Shuvadeep2407/cir/2.png

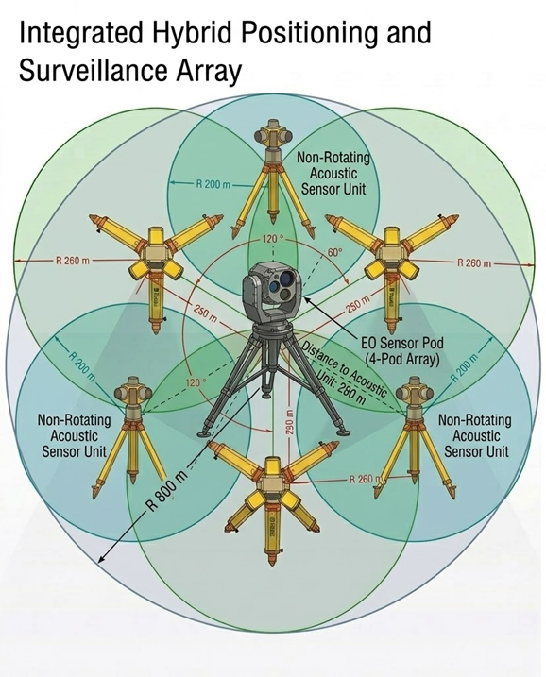
2.png
