Shuvadeep2407/cir/300 mm acoustic parabolic dish.jpg

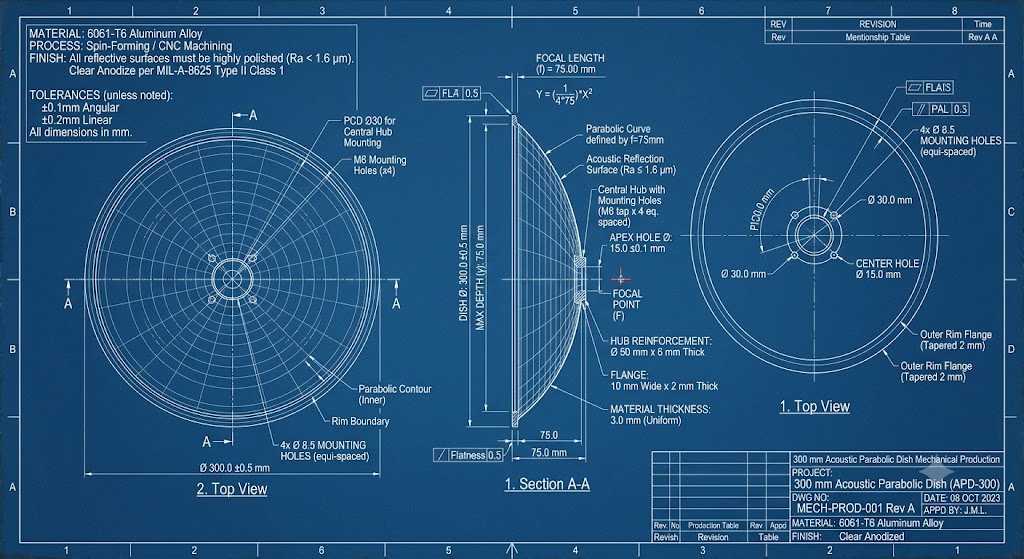
300 mm acoustic parabolic dish.jpg
