Shuvadeep2407/cir/UI/Software Development Responsibility.docx

# Software Development Responsibility & Client Discussion Requirements

## Project

AI-Based Counter Unmanned Aircraft System (C-UAS)

# Purpose

I am the hardware/system design engineer for this project.

The hardware architecture, sensors, mechanical design, and electronic systems are being developed separately.

The software architecture is NOT finalized because it depends on the client's operational requirements.

Therefore, before software development begins, the software development team must conduct a detailed requirement discussion with the client and recommend the most suitable software solution.

The software developer is responsible for software design decisions, user experience, algorithms, database architecture, APIs, and system integration.

# Responsibilities of the Software Development Team

The software development team shall analyze the customer's operational needs and determine the best software architecture.

The following items are not fixed and must be discussed with the client.

# 1. User Interface (UI/UX)

The hardware team does not know what interface the client requires.

The software developer must discuss:

- Dashboard layout
- Screen design
- Desktop application requirement
- Dark/Light theme
- Multi-language support
- Map layout
- Camera layout
- Radar display
- Alarm screen
- Operator workflow
- Ease of use
- Accessibility

The software developer shall create wireframes and UI mockups for client approval before implementation.

# 2. Data Collection & Integration

The software developer shall determine how all hardware data will be collected.

Topics to discuss:

- Real-time streaming
- Buffered data
- Event-based recording
- Continuous recording
- Communication protocols
- Data synchronization
- Timestamp synchronization
- Data validation
- Error recovery

The software developer shall design the complete data acquisition system.

# 3. PC Integration

The hardware provides sensor outputs.

The software developer shall determine:

- How data is received on the PC
- Driver requirements
- Communication middleware
- Data parser
- Background services
- Real-time processing
- Local storage
- Database
- Data backup
- Data recovery
- Automatic restart after power failure
- Offline operation
- Online synchronization

# 4. Database Design

The software developer shall determine:

- Database type
- Database schema
- Storage optimization
- Search capability
- Backup policy
- Recovery procedure
- Data retention
- Performance optimization

# 5. AI Algorithms

The hardware team will only provide sensor data.

The software developer shall determine:

- AI models
- Detection algorithms
- Tracking algorithms
- Sensor fusion algorithms
- False alarm filtering
- Object classification
- Confidence calculation
- Target association
- Prediction algorithms
- Performance optimization

The software team is responsible for selecting and training suitable AI models.

# 6. Sensor Fusion

The software developer shall determine:

- Fusion logic
- Sensor priority
- Confidence thresholds
- Time synchronization
- Error handling
- Conflict resolution
- Missing sensor handling
- Calibration procedures

# 7. Operator Workflow

Discuss with the client:

- What happens when a drone is detected?
- Who receives the first alert?
- Should tracking begin automatically?
- Should PTZ cameras move automatically?
- Should evidence recording start automatically?
- Who acknowledges alarms?
- Who closes incidents?
- How should reports be generated?

# 8. Notification System

Determine with the client:

- Alarm sounds
- Popup notifications
- SMS
- Email
- Mobile app notifications
- API integration
- External alarm systems
- Escalation rules

# 9. Reporting

Discuss:

- Daily reports
- Weekly reports
- Monthly reports
- Evidence reports
- Maintenance reports
- Audit logs
- Export formats (PDF, Excel, CSV)

# 10. User Management

Determine:

- User roles
- Permissions
- Authentication
- Password policy
- Audit logging
- Multi-user support

# 11. Deployment

The software developer shall determine:

- Operating System
- Installation method
- Automatic updates
- Docker or native installation
- Remote maintenance
- Monitoring
- Crash recovery
- Logging

# 12. Performance Requirements

The software developer shall propose and validate:

- Maximum simultaneous targets
- System latency
- CPU usage
- GPU usage
- Memory requirements
- Storage requirements
- Network bandwidth
- Scalability

# 13. Documentation

The software developer shall provide:

- Software Architecture Document
- Database Design Document
- API Documentation
- UI/UX Design
- User Manual
- Installation Guide
- Maintenance Guide
- Test Plan
- Test Reports
- Source Code Documentation

# Deliverables Expected from the Software Team

Before development begins, the software development team shall deliver:

1. Client Requirement Analysis
2. Software Requirement Specification (SRS)
3. UI/UX Mockups
4. Software Architecture Design
5. Database Design
6. API Design
7. AI Algorithm Proposal
8. Sensor Fusion Design
9. Communication Architecture
10. Risk Assessment
11. Development Schedule
12. Testing Plan

Development shall begin only after these documents have been reviewed and approved.

# Hardware Team Responsibility

The hardware team is responsible for:

- Sensor selection
- Mechanical design
- Electronics design
- PCB design
- Power systems
- Wiring
- Communication interfaces
- Hardware testing
- Hardware documentation

The hardware team is not responsible for software UI design, AI algorithm selection, database design, software architecture, or application workflow. Those responsibilities belong to the software development team in consultation with the client.
