Shuvadeep2407/cir/pos.pptx

## Radar Position

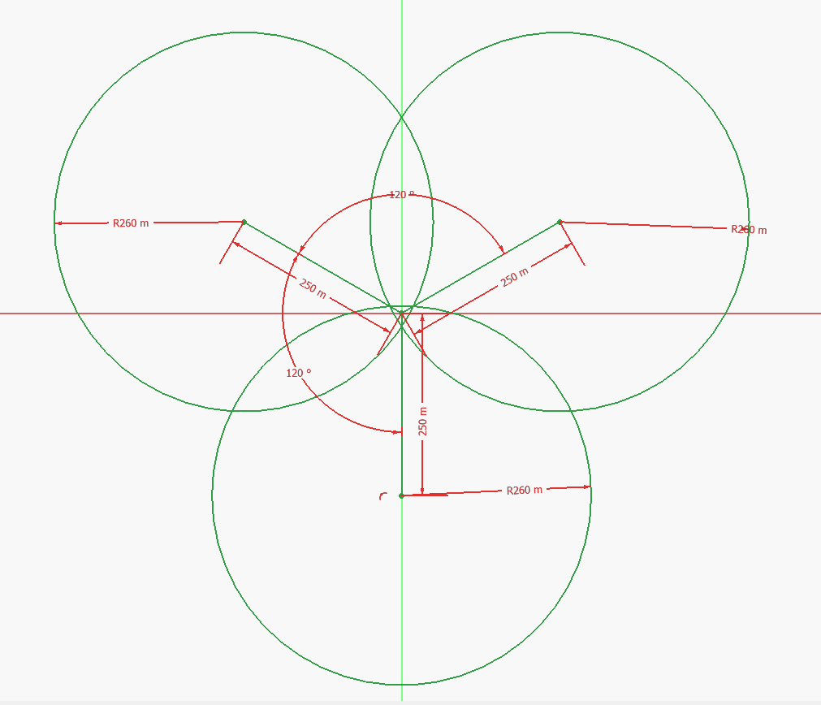
[picture p5: figure]

Radar
r 260m

## Slide 2

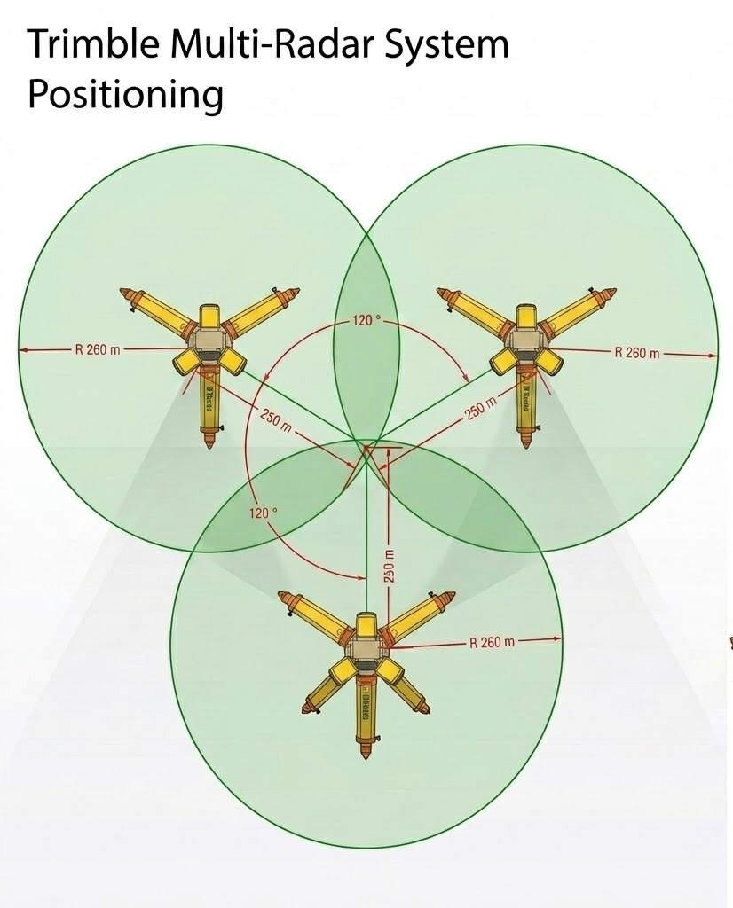
[picture p6: figure]

## Slide 3

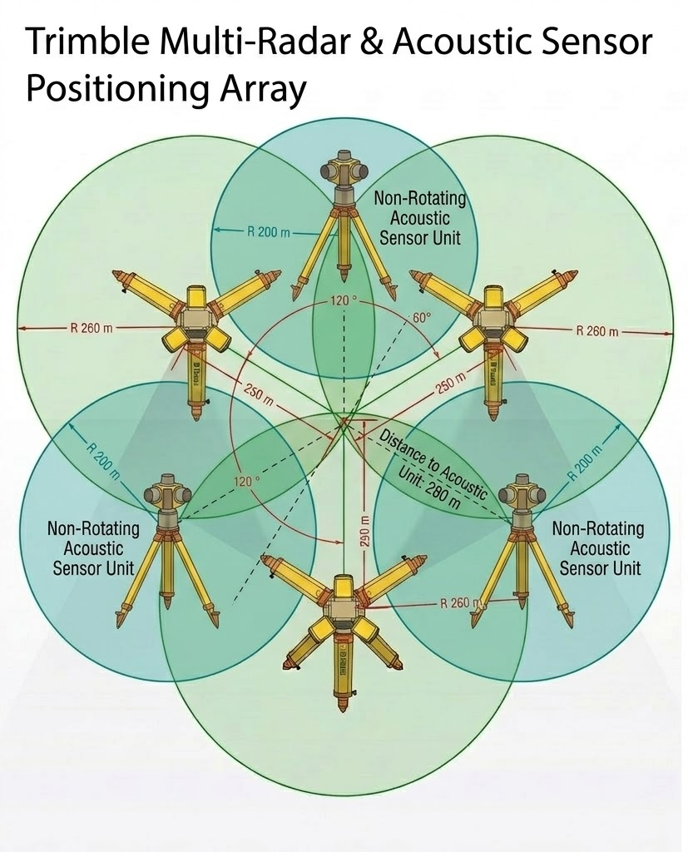
[picture p7: figure]

## Slide 4

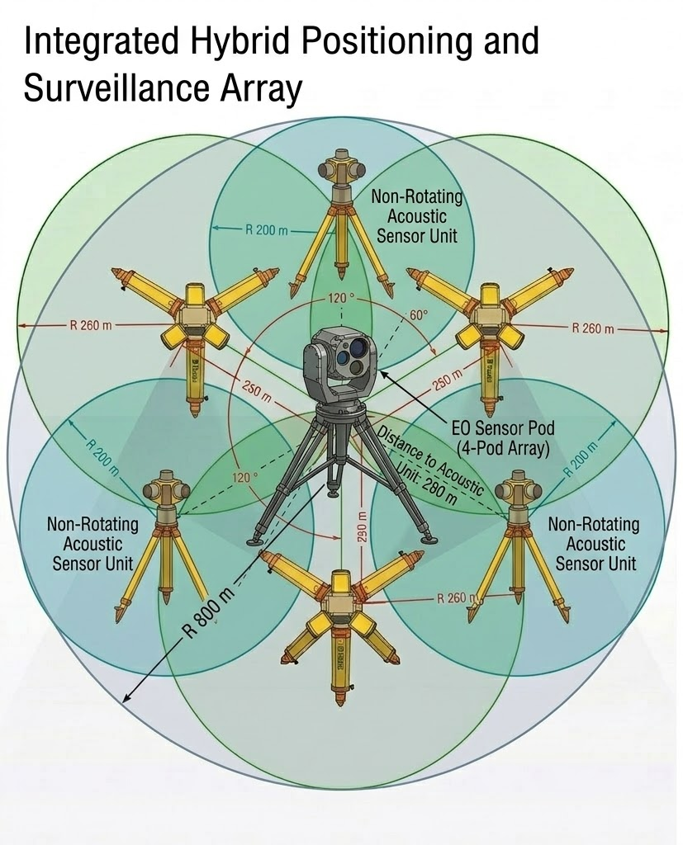
[picture p8: figure]

## Slide 5

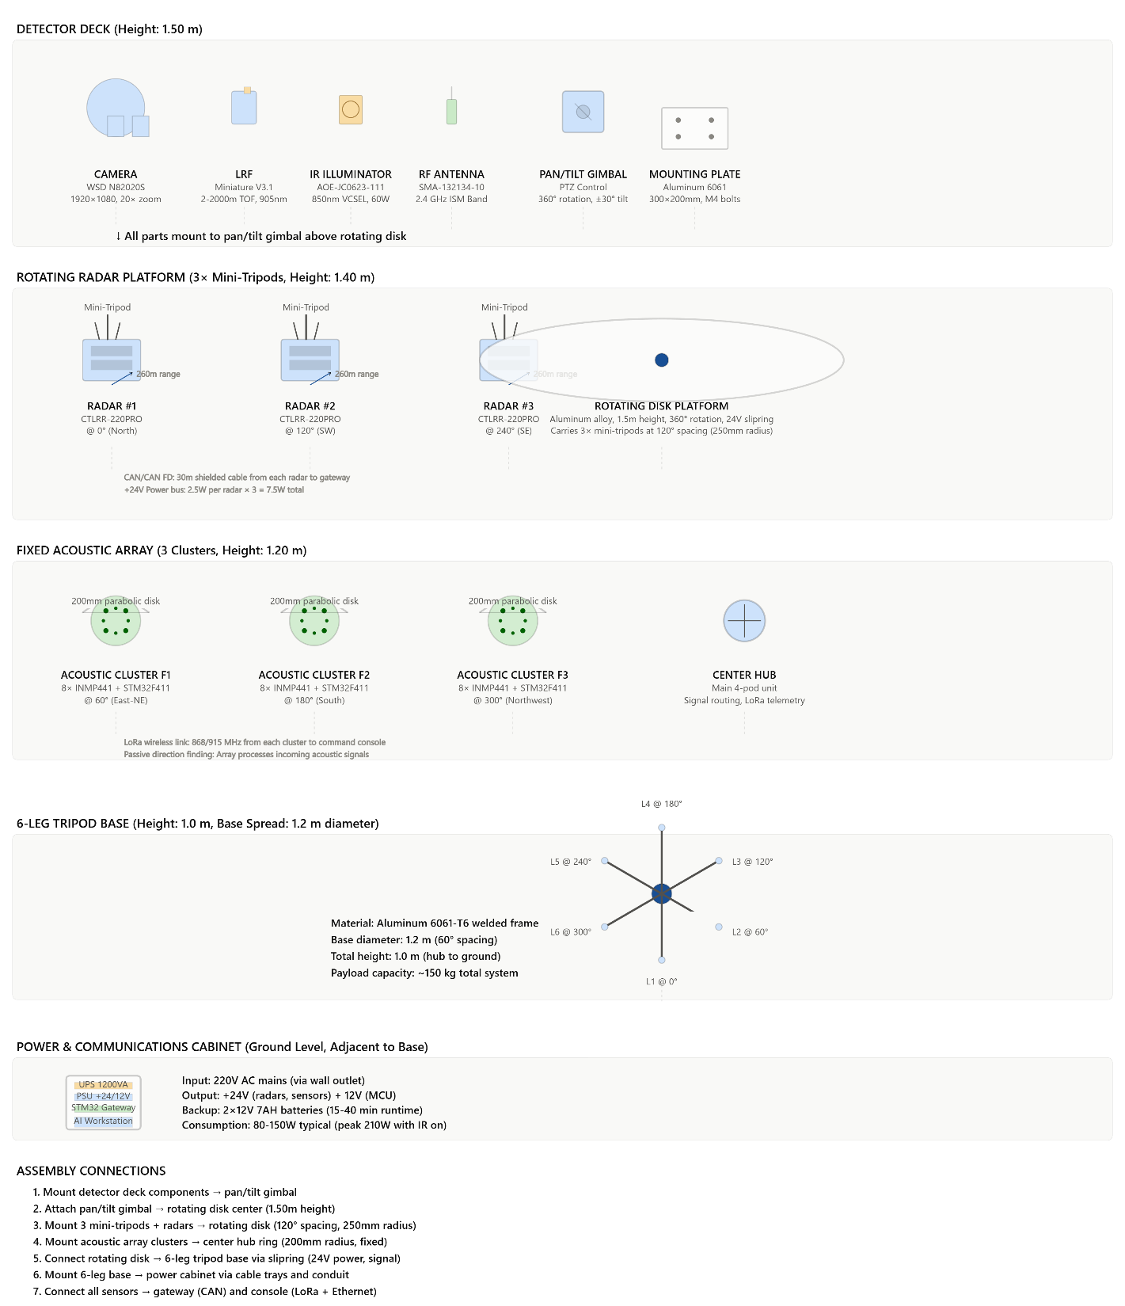
[picture p9: figure]

## Slide 6

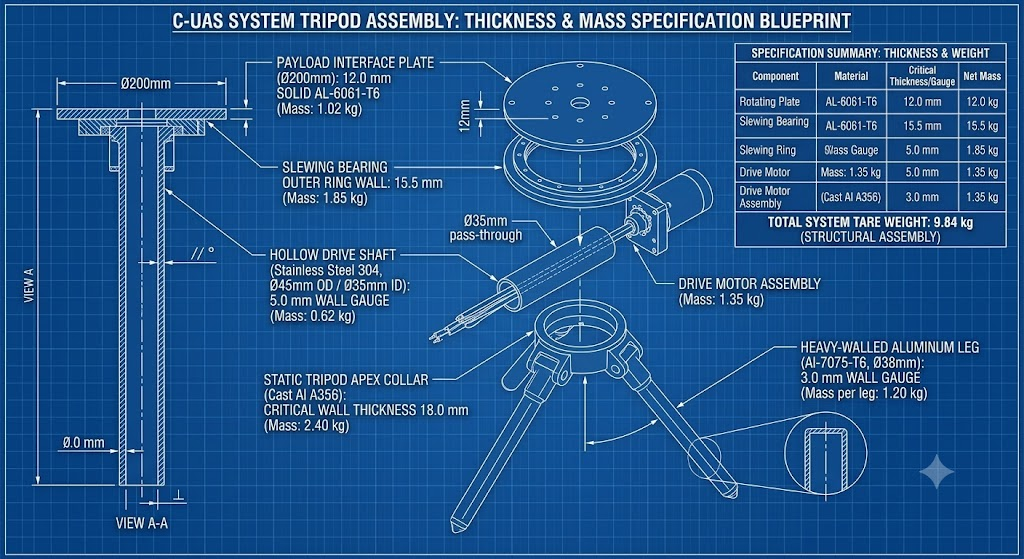
[picture p10: figure]
