Shuvadeep2407/cir/cam mod ds.jpeg

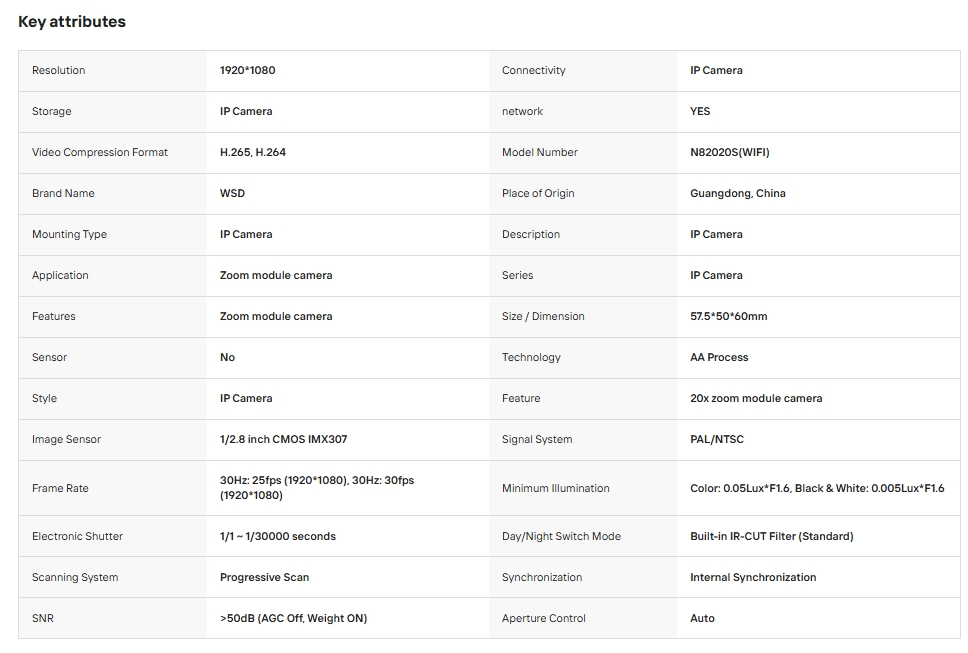
cam mod ds.jpeg
