Shuvadeep2407/cir/s1.png

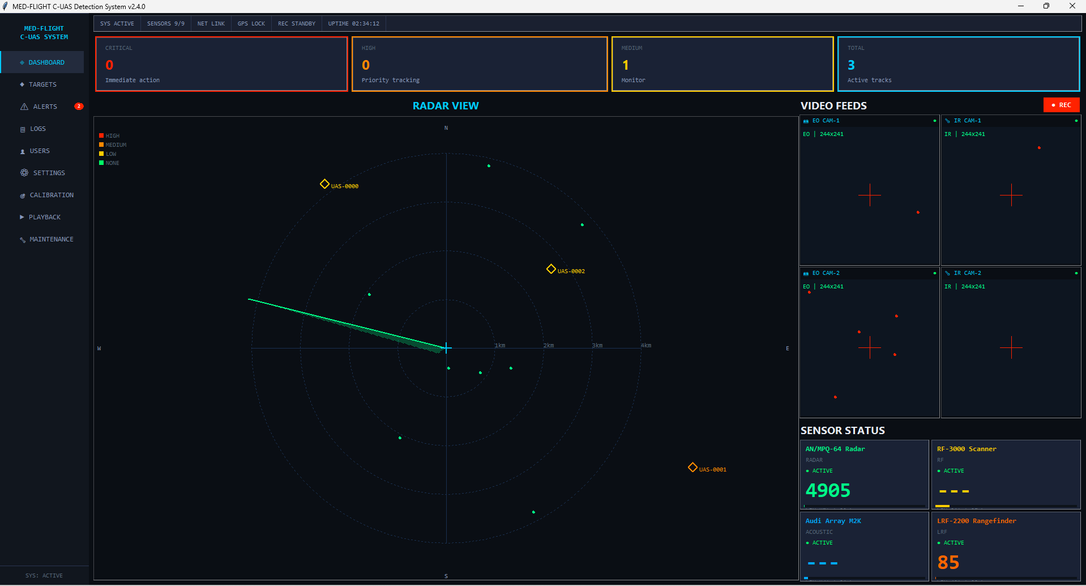
s1.png
