Shuvadeep2407/cir/s2.png

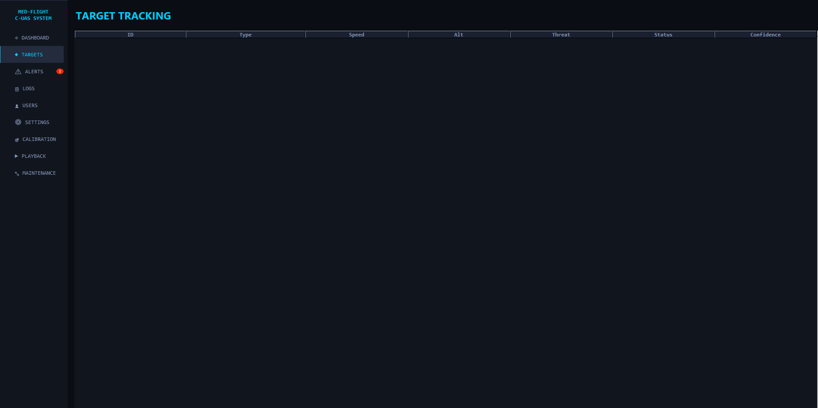
s2.png
