Shuvadeep2407/cir/s3.png

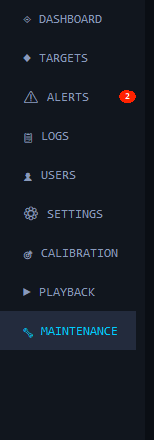
s3.png
