Shuvadeep2407/cir/cost/expense_sheet.xlsx

Date | Category | Item | Currency | Cost (BDT)
6/29/2026 | STAND | Material | BDT | 10000.00
6/29/2026 | PARABOLIC DISH | Material | BDT | 6000.00
6/29/2026 | CONVANS | Convans | BDT | 500.00
6/29/2026 | ELECTRONICS | Electronics | BDT | 30000.00
6/29/2026 | TOOL | Electronics | BDT | 3500.00
6/29/2026 | CONVANS | Convans | BDT | 500.00
6/29/2026 | Long Range Millimeter Wave Radar | Electronics | BDT | 79000.00 | 79000.00
6/30/2026 | data link Module | Electronics | BDT | 23000.00 | 23000.00
6/30/2026 | 2.4G Yagi antenna | Material | BDT | 1920.00 | 1920.00
6/30/2026 | Optic Laser Rangefinder Module | Electronics | BDT | 20000.00 | 20000.00
6/30/2026 | Infrared Laser Light Bulb | Electronics | BDT | 21000.00 | 21000.00
6/30/2026 | Stepper Motor NEMA 17 | Electronics | BDT | 4500.00 | 4500.00
6/30/2026 | 30x Zoom Camera | Electronics | BDT | 18500.00 | 18500.00
6/30/2026 | TOOL | Material | BDT | 500.00
7/2/2026 | WORKSHOP cutting | Labor | BDT | 500.00
7/2/2026 | fiting | Labor | BDT | 500.00
2026-07-03 | color | Tools | BDT | 1500.00
2026-07-03 | CONVANS | Convans | BDT | 500.00
2026-07-03 | WORKSHOP | Labor | BDT | 2000.00
2026-07-06 | WORKSHOP | Workshop | BDT | 500.00
2026-07-06 | PCB | PCB | BDT | 10000.00
2026-07-06 | CONVANS | Convans | BDT | 500.00
2026-07-12 | WORKSHOP | Labor | BDT | 1000.00
2026-07-12 | TOOL | Material | BDT | 1000.00
2026-07-12 | CONVANS | Convans | BDT | 1500.00
2026-07-12 | shipping fee china to bd | shipping | BDT | 12000.00
2026-07-14 | pathao | shipping | BDT | 480.00
2026-07-14 | shuvadeep | funding | BDT | 5600.00 | 600
 | TOTAL |  |  | 256500.00
2026-07-14 | jammer | Electronics | BDT | 22800.00
2026-07-16 | pc | Electronics | BDT | 55500.00
2026-07-16 | shuvadeep | funding | BDT | 39500.00
 | TOTAL |  |  | 374300.00
2026-07-28 | shuvadeep | funding | BDT | 10000.00 |  | ai shiping 4000 + 6000 cash
2026-07-28 | pathao | persel | BDT | 200.00
2026-07-31 | shuvadeep | funding | BDT | 3235.00
2026-08-02 | shuvadeep | funding | BDT | 10000.00
2026-08-08 | Nihar sir | dhaka to ctg | BDT | 1153.00
 |  |  |  |  | 168520.00
 |  |  | GRAND TOTAL | 398888.00 | Shuvodip 61400
 |  |  |  |  | Nihar 24735
 |  |  |  |  | Zahangir 81775
 |  |  |  |  | 167910
