Shuvadeep2407/cir/cost.pptx

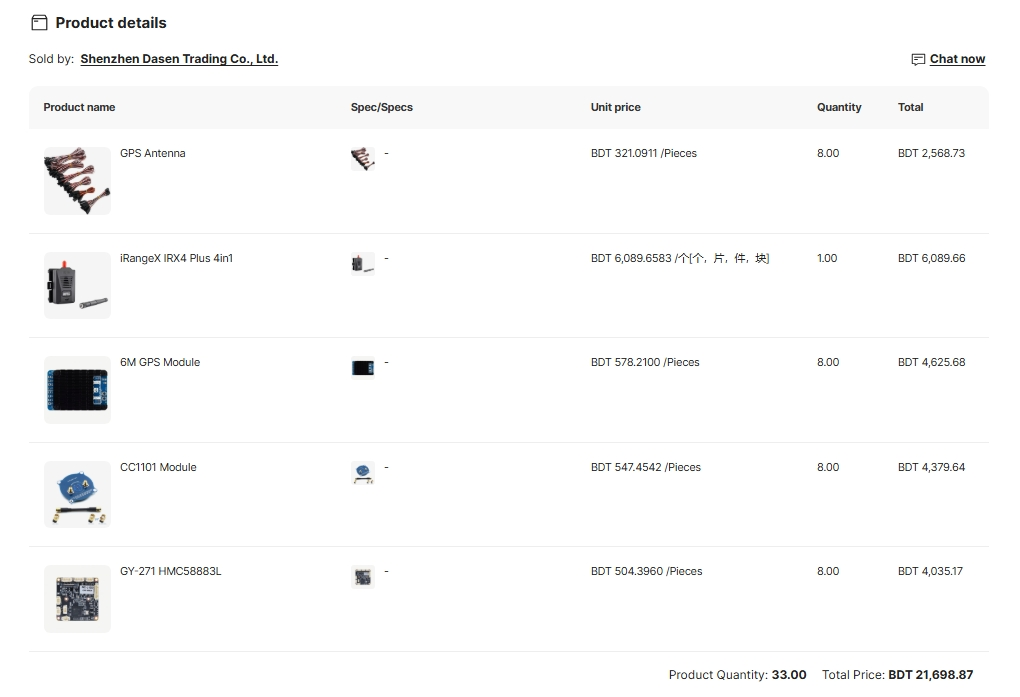
[picture p15: figure]

## Slide 2

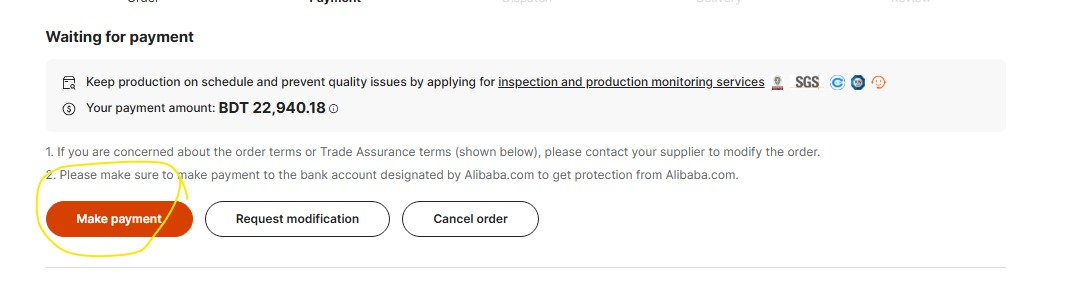
[picture p16: figure]
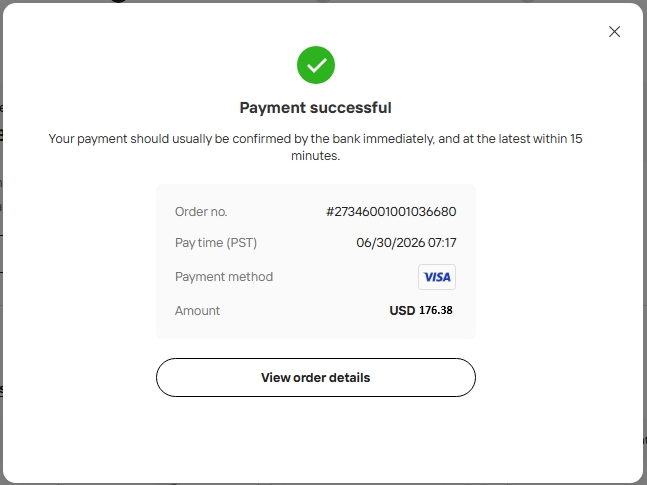
[picture p17: figure]
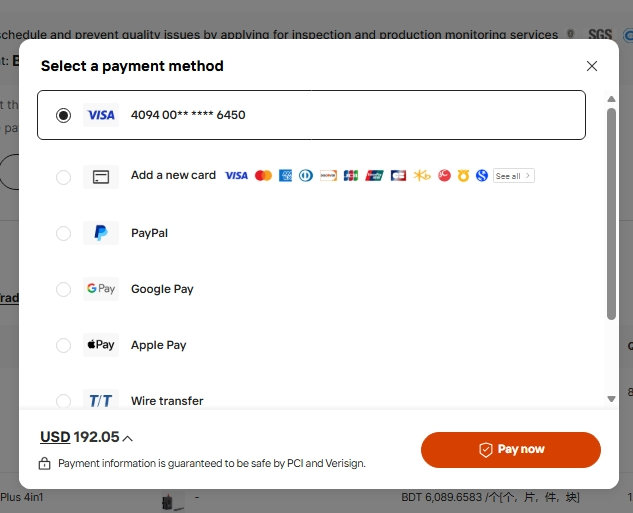
[picture p18: figure]

## Slide 3

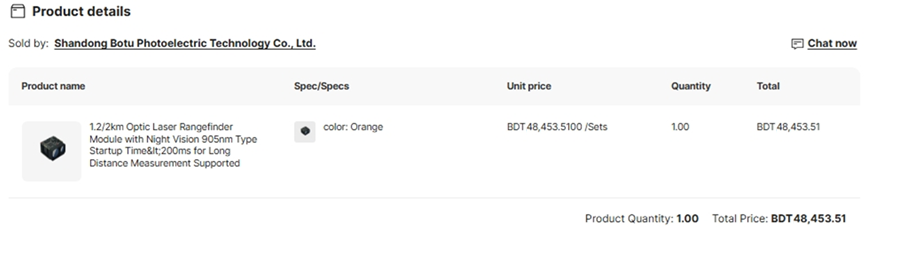
[picture p19: figure]
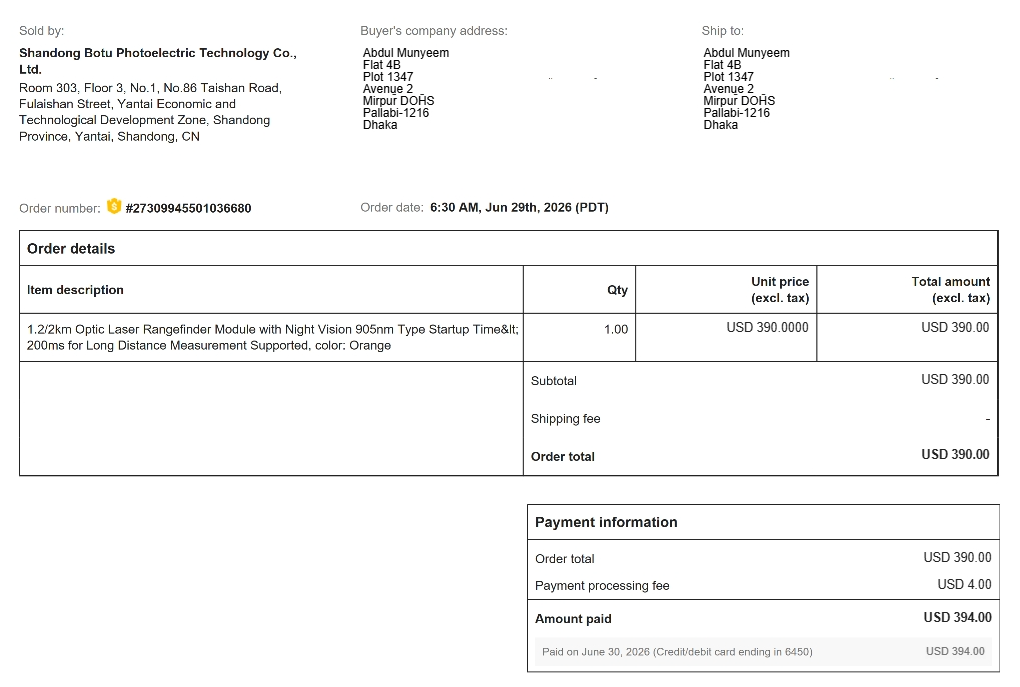
[picture p20: figure]
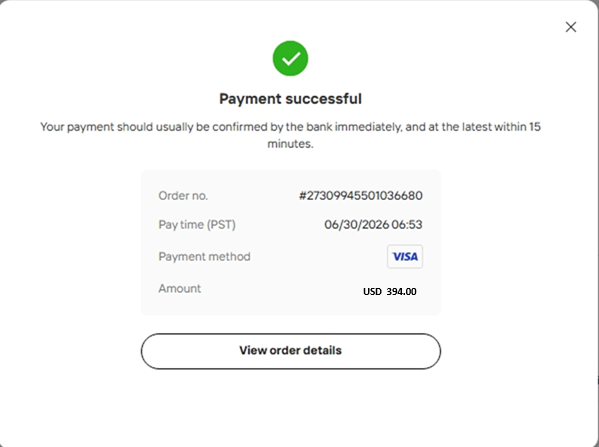
[picture p21: figure]

## Slide 4

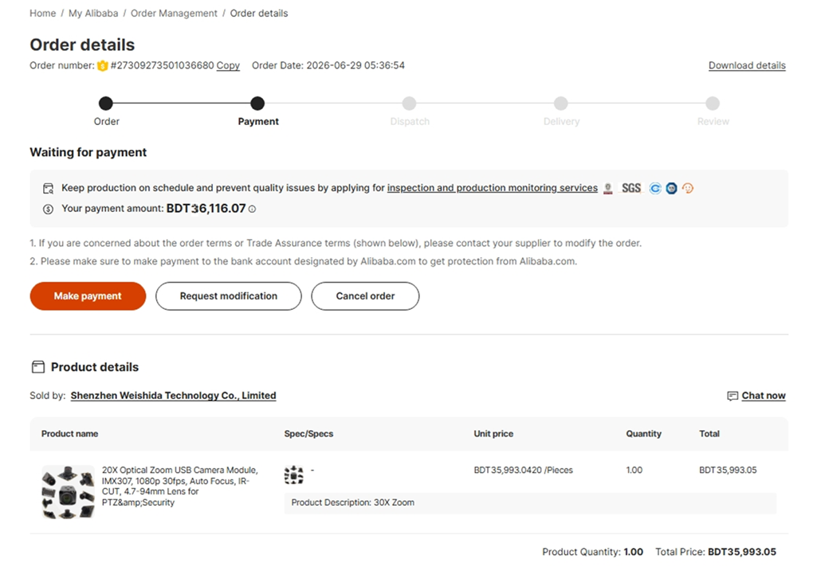
[picture p22: figure]

## Slide 5

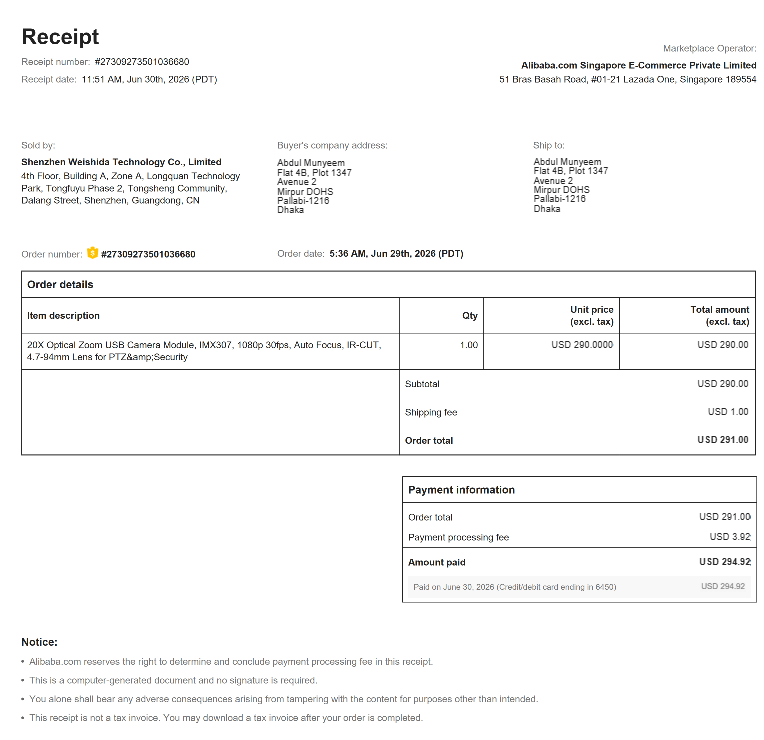
[picture p23: figure]
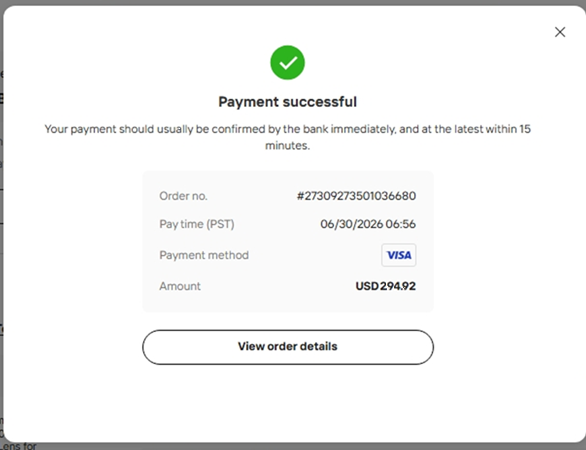
[picture p24: figure]

## Slide 6

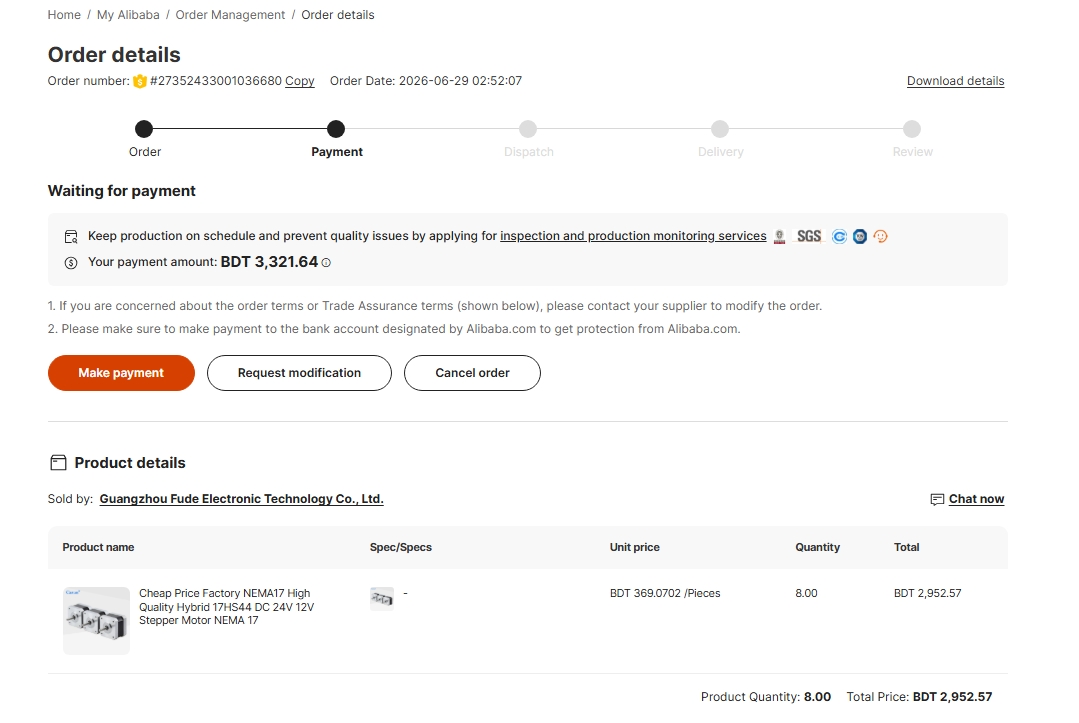
[picture p25: figure]
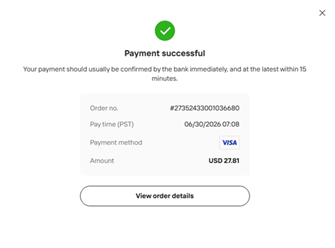
[picture p26: figure]

## Slide 7

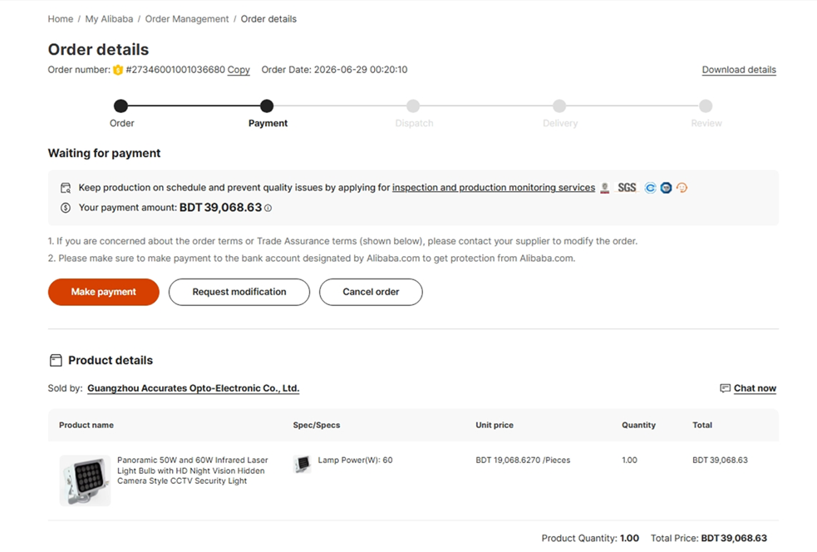
[picture p27: figure]

## Slide 8

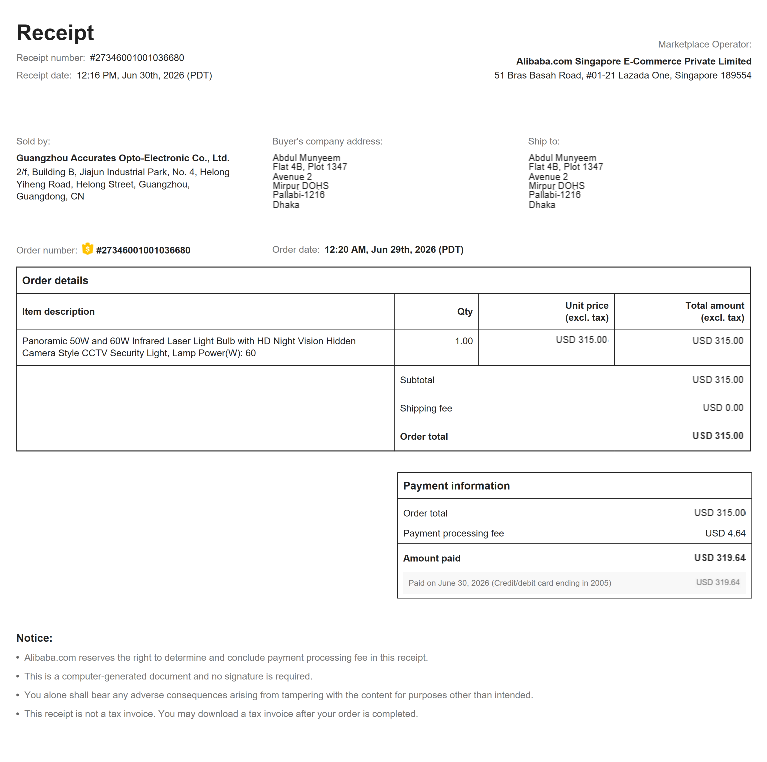
[picture p28: figure]
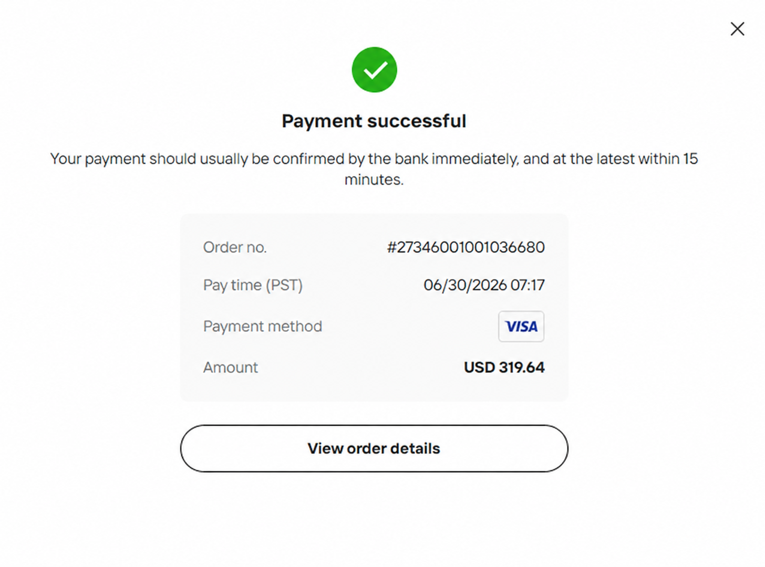
[picture p29: figure]

## Slide 9

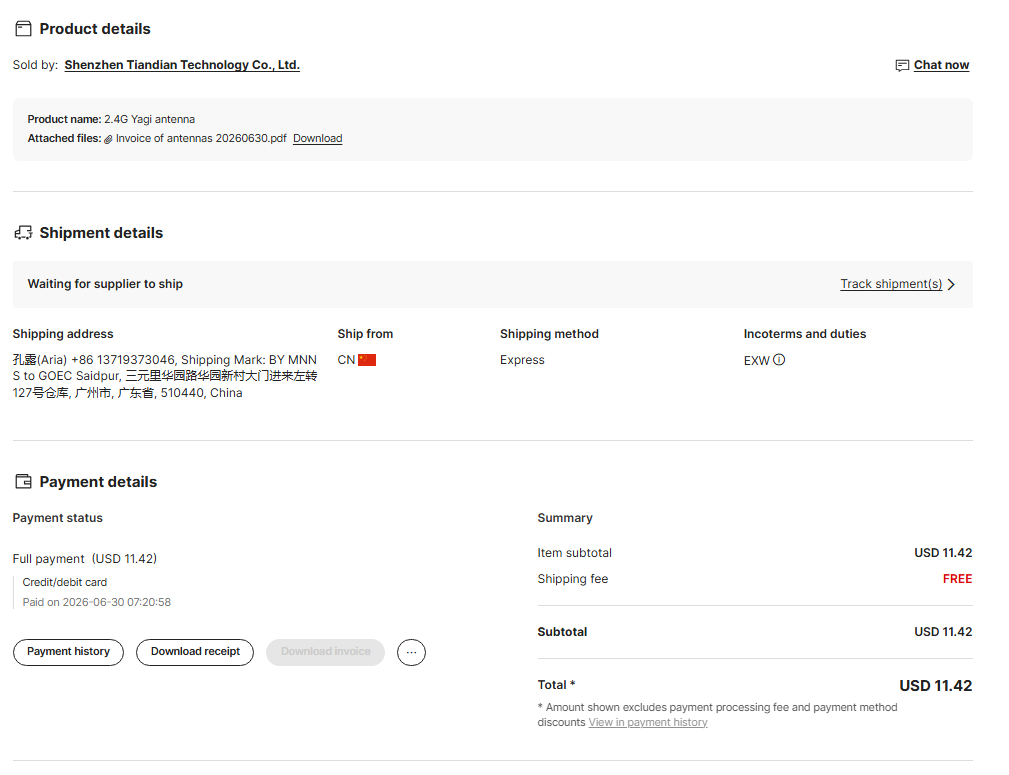
[picture p30: figure]
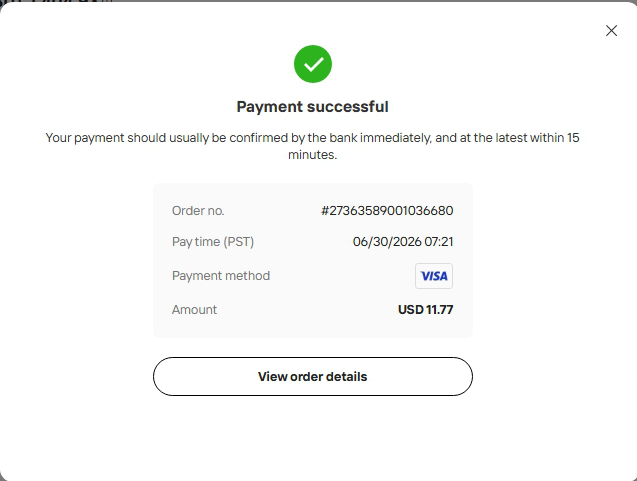
[picture p31: figure]

## Slide 10

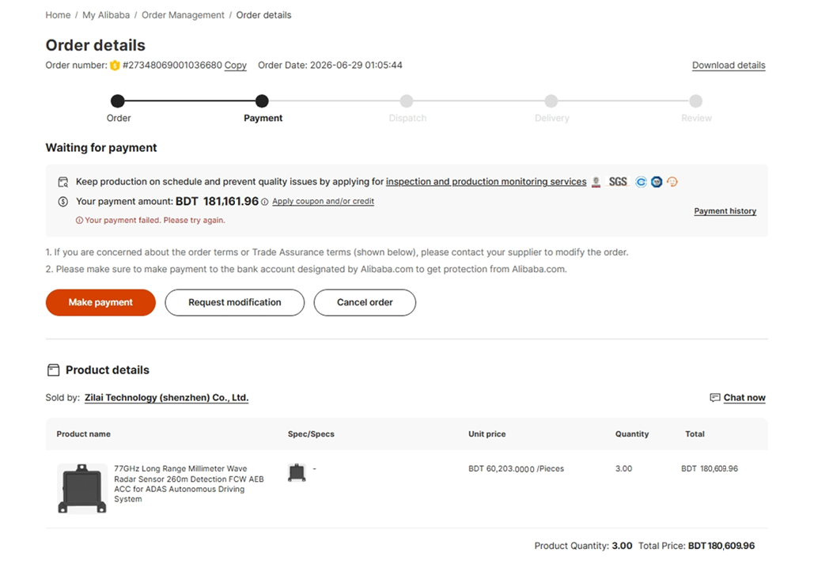
[picture p32: figure]

## Slide 11

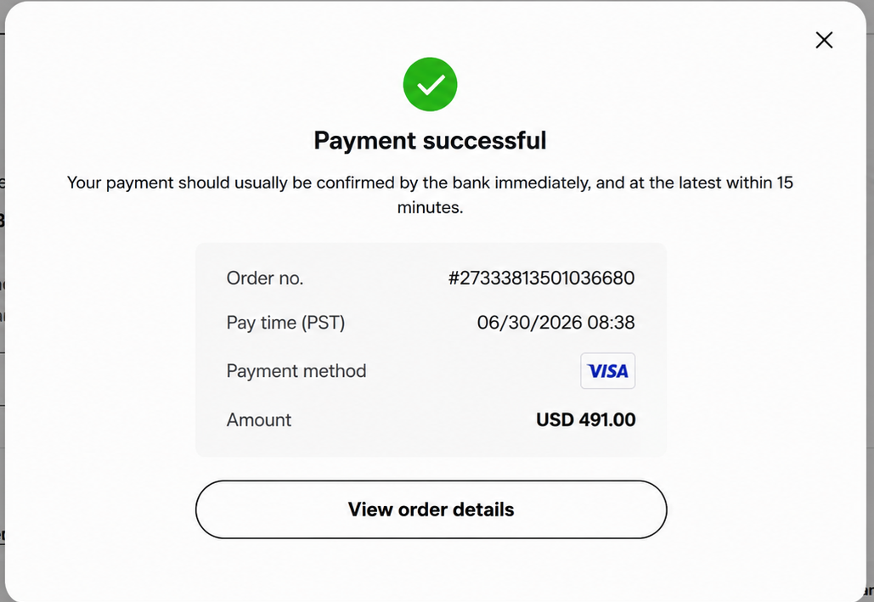
[picture p33: figure]
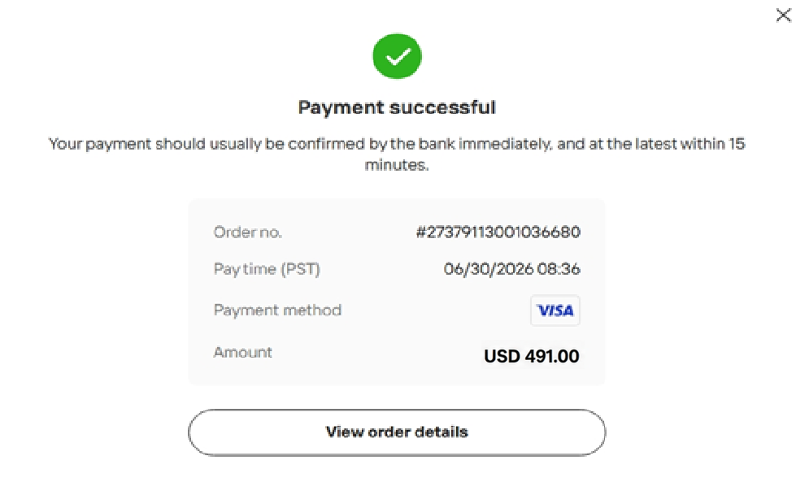
[picture p34: figure]
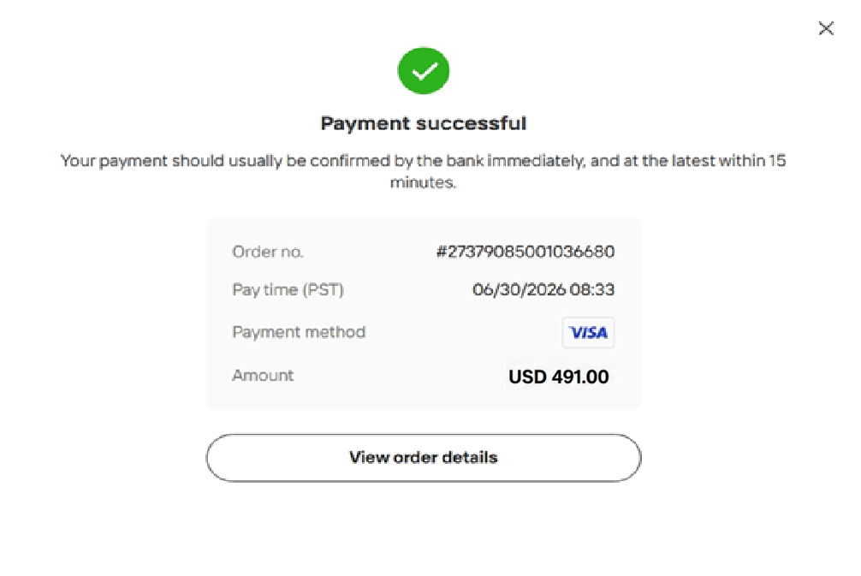
[picture p35: figure]

## Slide 12

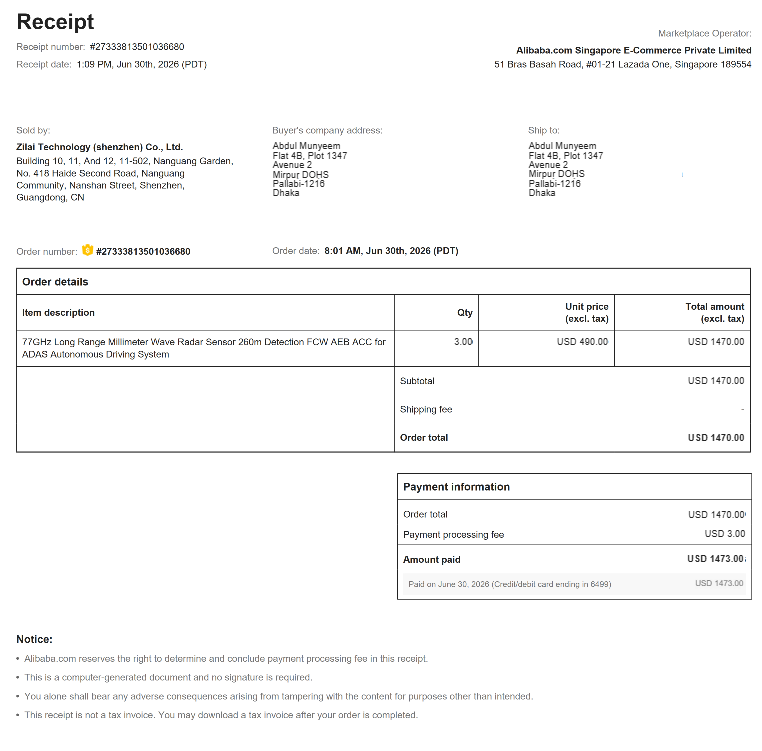
[picture p36: figure]
