Shuvadeep2407/cir/KiCADv6/IC_LQFP48_5B_STM.stl

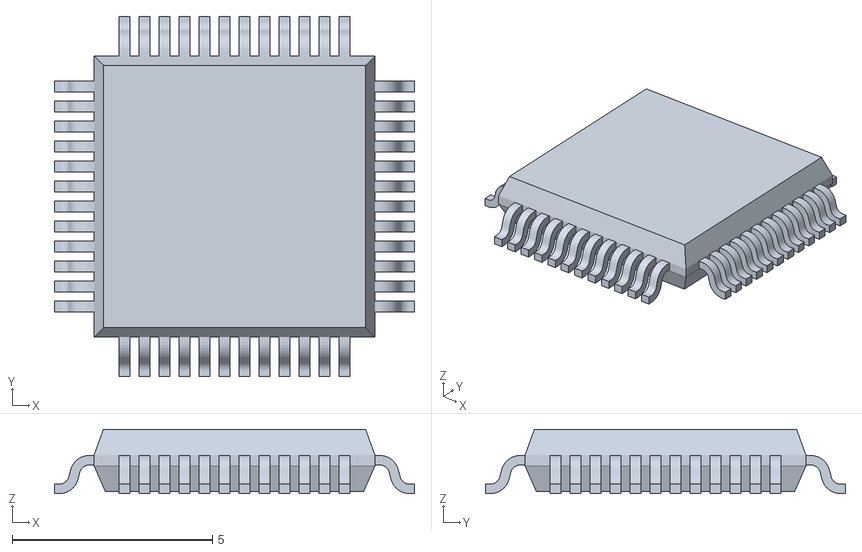
[picture p37: CAD file, 2026-08-02]
KiCADv6/IC_LQFP48_5B_STM.stl
8.99 x 8.99 x 1.60
