Shuvadeep2407/cir/drone control/KiCad/rader/rader/rader.kicad_pcb

## KiCad design drone control/KiCad/rader/rader/rader.kicad_pcb (2026-08-02)

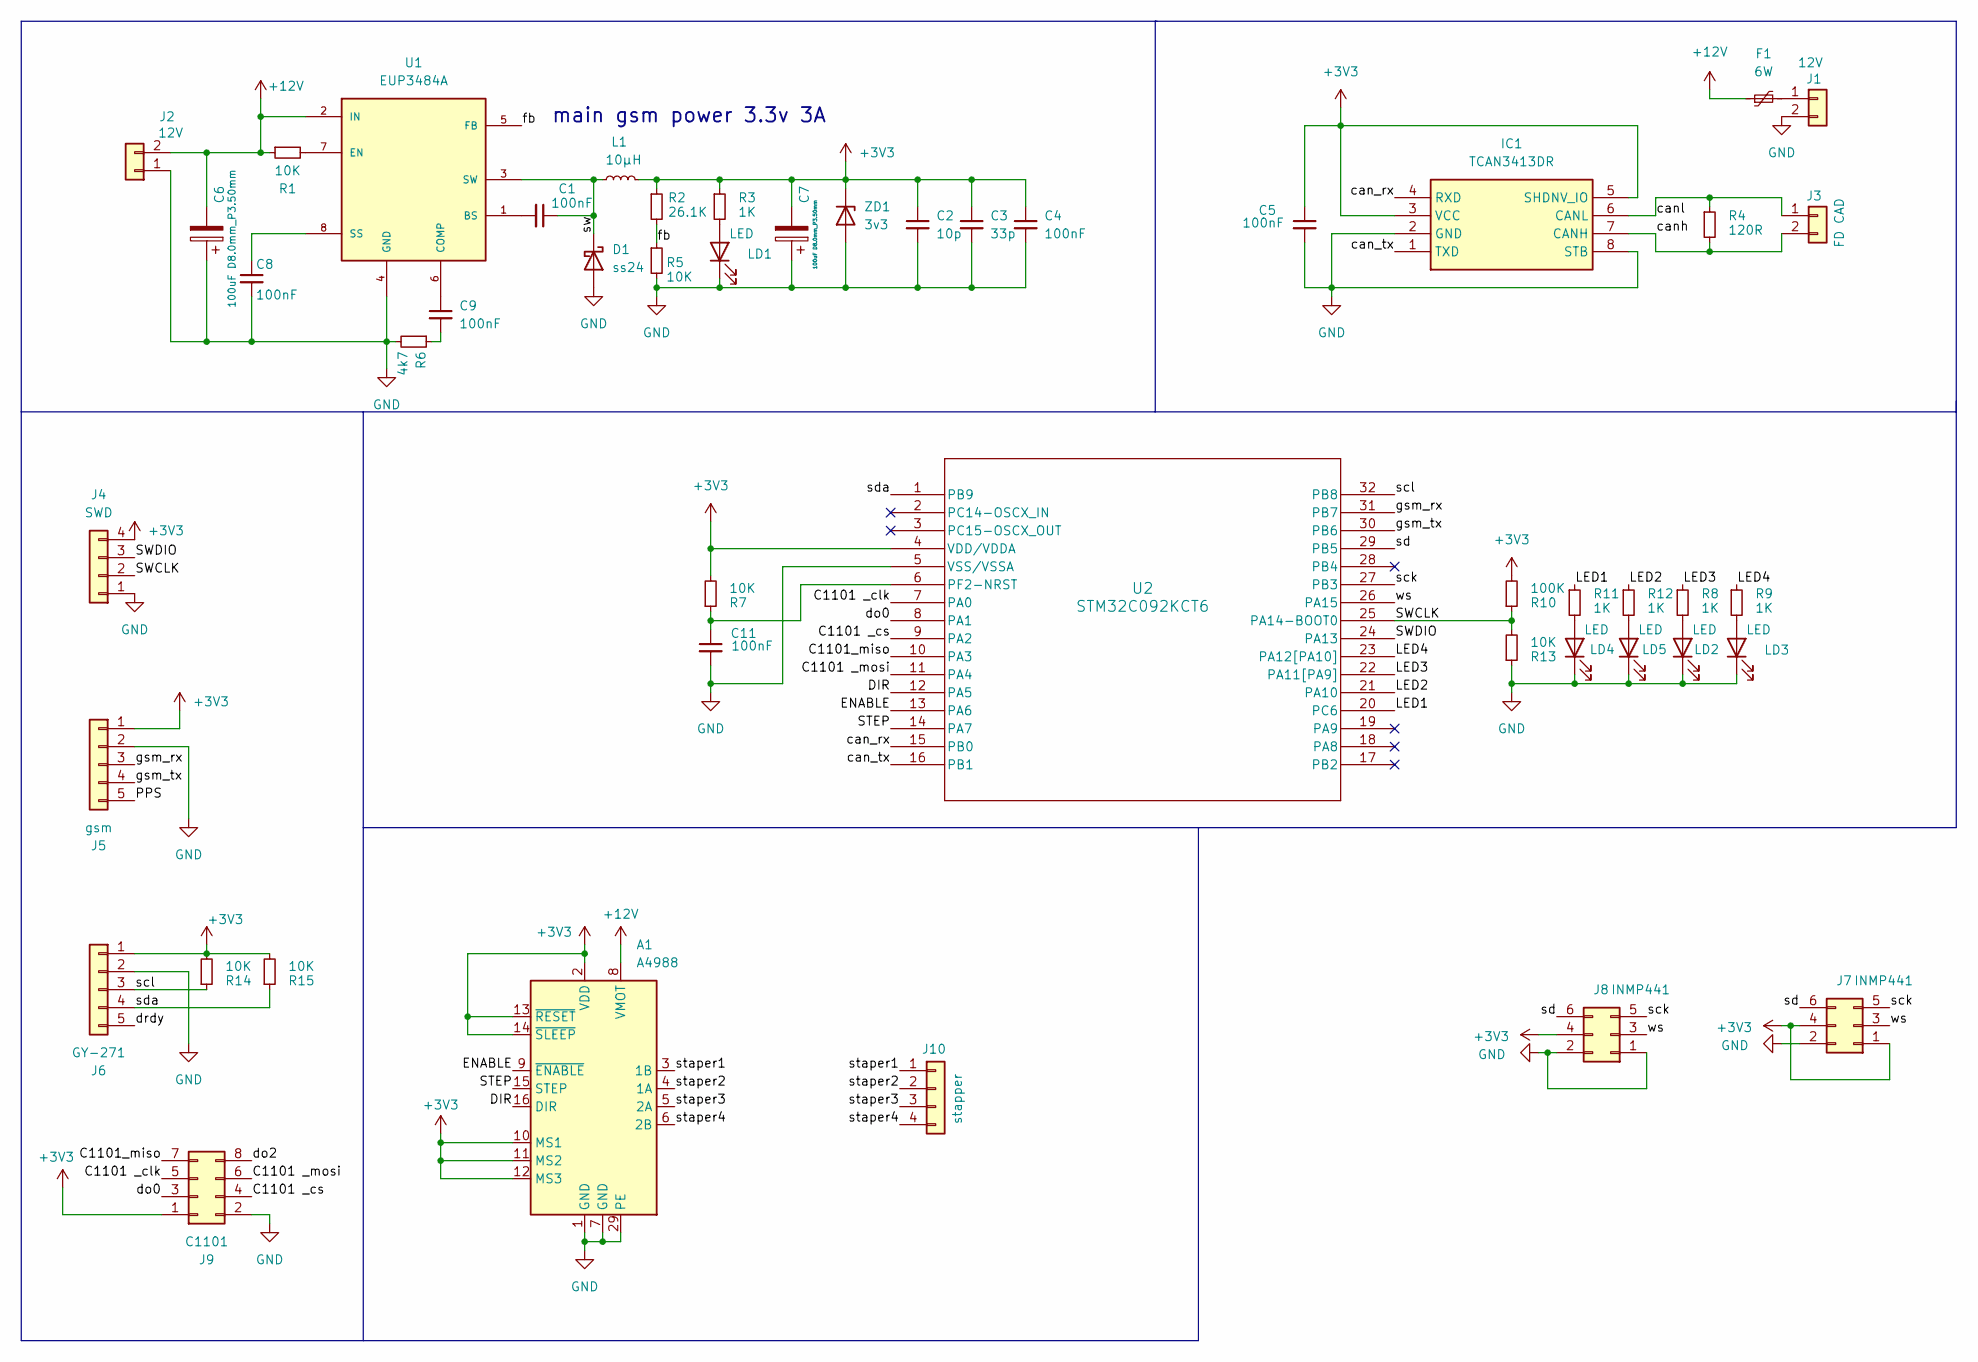
[picture p38: schematic rader.kicad_sch]

Parts:
A1: A4988; Pololu_Breakout-16_15.2x20.3mm
C1, C4, C5, C8, C9, C11: 100nF; C_0603_1608Metric
C2: 10p; C_0603_1608Metric
C3: 33p; C_0603_1608Metric
C6, C7: 100uF D8.0mm_P3.50mm; CP_Radial_D6.3mm_P2.50mm
D1: ss24; D_SMB
F1: 6W; Fuse_1206_3216Metric
IC1: TCAN3413DR; SOIC127P600X175-8N; Manufacturer_Part_Number TCAN3413DR; Mouser Part Number 595-TCAN3413DR
J1, J2: 12V; PinHeader_1x02_P2.54mm_Vertical
J3: FD CAD; PinHeader_1x02_P2.54mm_Vertical
J4: SWD; PinHeader_1x04_P2.54mm_Vertical
J5: gsm; PinHeader_1x05_P2.54mm_Vertical
J6: GY-271; PinHeader_1x05_P2.54mm_Vertical
J7, J8: INMP441; PinHeader_2x03_P2.54mm_Vertical
J9: C1101; PinHeader_2x04_P2.54mm_Vertical
J10: stapper; PinHeader_1x04_P2.54mm_Vertical
L1: 10µH; CP_Radial_Tantal_D4.5mm_P2.50mm
LD1, LD2, LD3, LD4, LD5: LED; LED_0603_1608Metric
R1, R5, R7, R13, R14, R15: 10K; R_0603_1608Metric
R2: 26.1K; R_0603_1608Metric
R3, R8, R9, R11, R12: 1K; R_0603_1608Metric
R4: 120R; R_0603_1608Metric
R6: 4k7; R_0603_1608Metric
R10: 100K; R_0603_1608Metric
U1: EUP3484A; SOIC-8_3.9x4.9mm_P1.27mm
U2: STM32C092KCT6; LQFP-32_7x7mm_P0.8mm
ZD1: 3v3; D_SMB

Connections:
+3V3: A1.2 (VDD), A1.10 (MS1), A1.11 (MS2), A1.12 (MS3), A1.13 (~RESET), A1.14 (~SLEEP), C2.1, C3.1, C4.1, C5.1, C7.2, IC1.3 (VCC), IC1.5 (SHDNV_IO), J4.4, J5.1, J6.1, J7.1, J7.4, J8.4, J9.1, L1.2, R2.1, R3.1, R7.2, R10.2, R14.2, R15.2, U2.4 (VDD/VDDA), ZD1.1 (K)
+12V: A1.8 (VMOT), C6.2, F1.1, J2.2, R1.1, U1.2 (IN)
/C1101 _clk: J9.5, U2.7 (PA0)
/C1101 _cs: J9.4, U2.9 (PA2)
/C1101 _mosi: J9.6, U2.11 (PA4)
/C1101_miso: J9.7, U2.10 (PA3)
/DIR: A1.16 (DIR), U2.12 (PA5)
/ENABLE: A1.9 (~ENABLE), U2.13 (PA6)
/LED1: R11.1, U2.20 (PC6)
/LED2: R12.1, U2.21 (PA10)
/LED3: R8.1, U2.22 (PA11[PA9])
/LED4: R9.1, U2.23 (PA12[PA10])
/PPS: J5.5
/STEP: A1.15 (STEP), U2.14 (PA7)
/SWCLK: J4.2, R10.1, R13.2, U2.25 (PA14-BOOT0)
/SWDIO: J4.3, U2.24 (PA13)
/can_rx: IC1.4 (RXD), U2.15 (PB0)
/can_tx: IC1.1 (TXD), U2.16 (PB1)
/canh: IC1.7 (CANH), J3.2, R4.2
/canl: IC1.6 (CANL), J3.1, R4.1
/do0: J9.3, U2.8 (PA1)
/do2: J9.8
/drdy: J6.5
/fb: R2.2, R5.1, U1.5 (FB)
/gsm_rx: J5.3, U2.31 (PB7)
/gsm_tx: J5.4, U2.30 (PB6)
/sck: J7.5, J8.5, U2.27 (PB3)
/scl: J6.3, R14.1, U2.32 (PB8)
/sd: J7.6, J8.6, U2.29 (PB5)
/sda: J6.4, R15.1, U2.1 (PB9)
/staper1: A1.3 (1B), J10.1
/staper2: A1.4 (1A), J10.2
/staper3: A1.5 (2A), J10.3
/staper4: A1.6 (2B), J10.4
/sw: C1.1, D1.1 (K), L1.1, U1.3 (SW)
/ws: J7.3, J8.3, U2.26 (PA15)
GND: A1.1 (GND), A1.7 (GND), A1.29 (PE), C2.2, C3.2, C4.2, C5.2, C6.1, C7.1, C8.2, C11.2, D1.2 (A), IC1.2 (GND), IC1.8 (STB), J1.2, J2.1, J4.1, J5.2, J6.2, J7.2, J8.1, J8.2, J9.2, LD1.1 (K), LD2.1 (K), LD3.1 (K), LD4.1 (K), LD5.1 (K), R5.2, R6.2, R13.1, U1.4 (GND), U2.5 (VSS/VSSA), ZD1.2 (A)
unnamed: C9.2, R6.1
unnamed: F1.2, J1.1
unnamed: LD1.2 (A), R3.2
unnamed: LD2.2 (A), R8.2
unnamed: LD3.2 (A), R9.2
unnamed: LD4.2 (A), R11.2
unnamed: LD5.2 (A), R12.2
unnamed: C1.2, U1.1 (BS)
unnamed: C9.1, U1.6 (COMP)
unnamed: R1.2, U1.7 (EN)
unnamed: C8.1, U1.8 (SS)
unnamed: C11.1, R7.1, U2.6 (PF2-NRST)

Notes on the sheet:
main gsm power 3.3v 3A

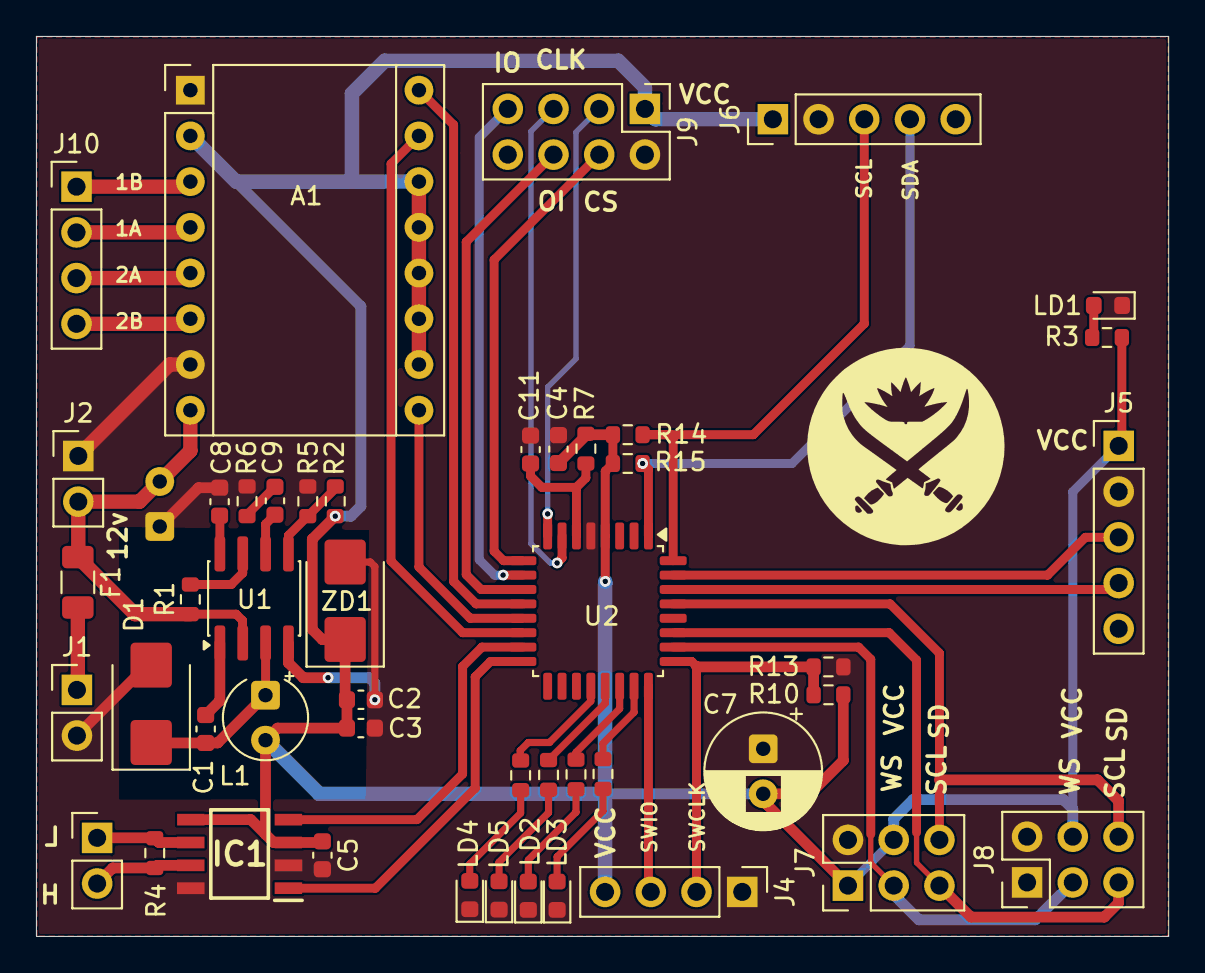
[picture p39: board rader.kicad_pcb from above]

Board: 2 copper layers, 62.9 x 50.0 mm, 48 parts (1 on the bottom side), 46 nets.
