Shuvadeep2407/cir/drone control/drone/drone.kicad_sch

## KiCad design drone control/drone/drone.kicad_sch (2026-08-02)

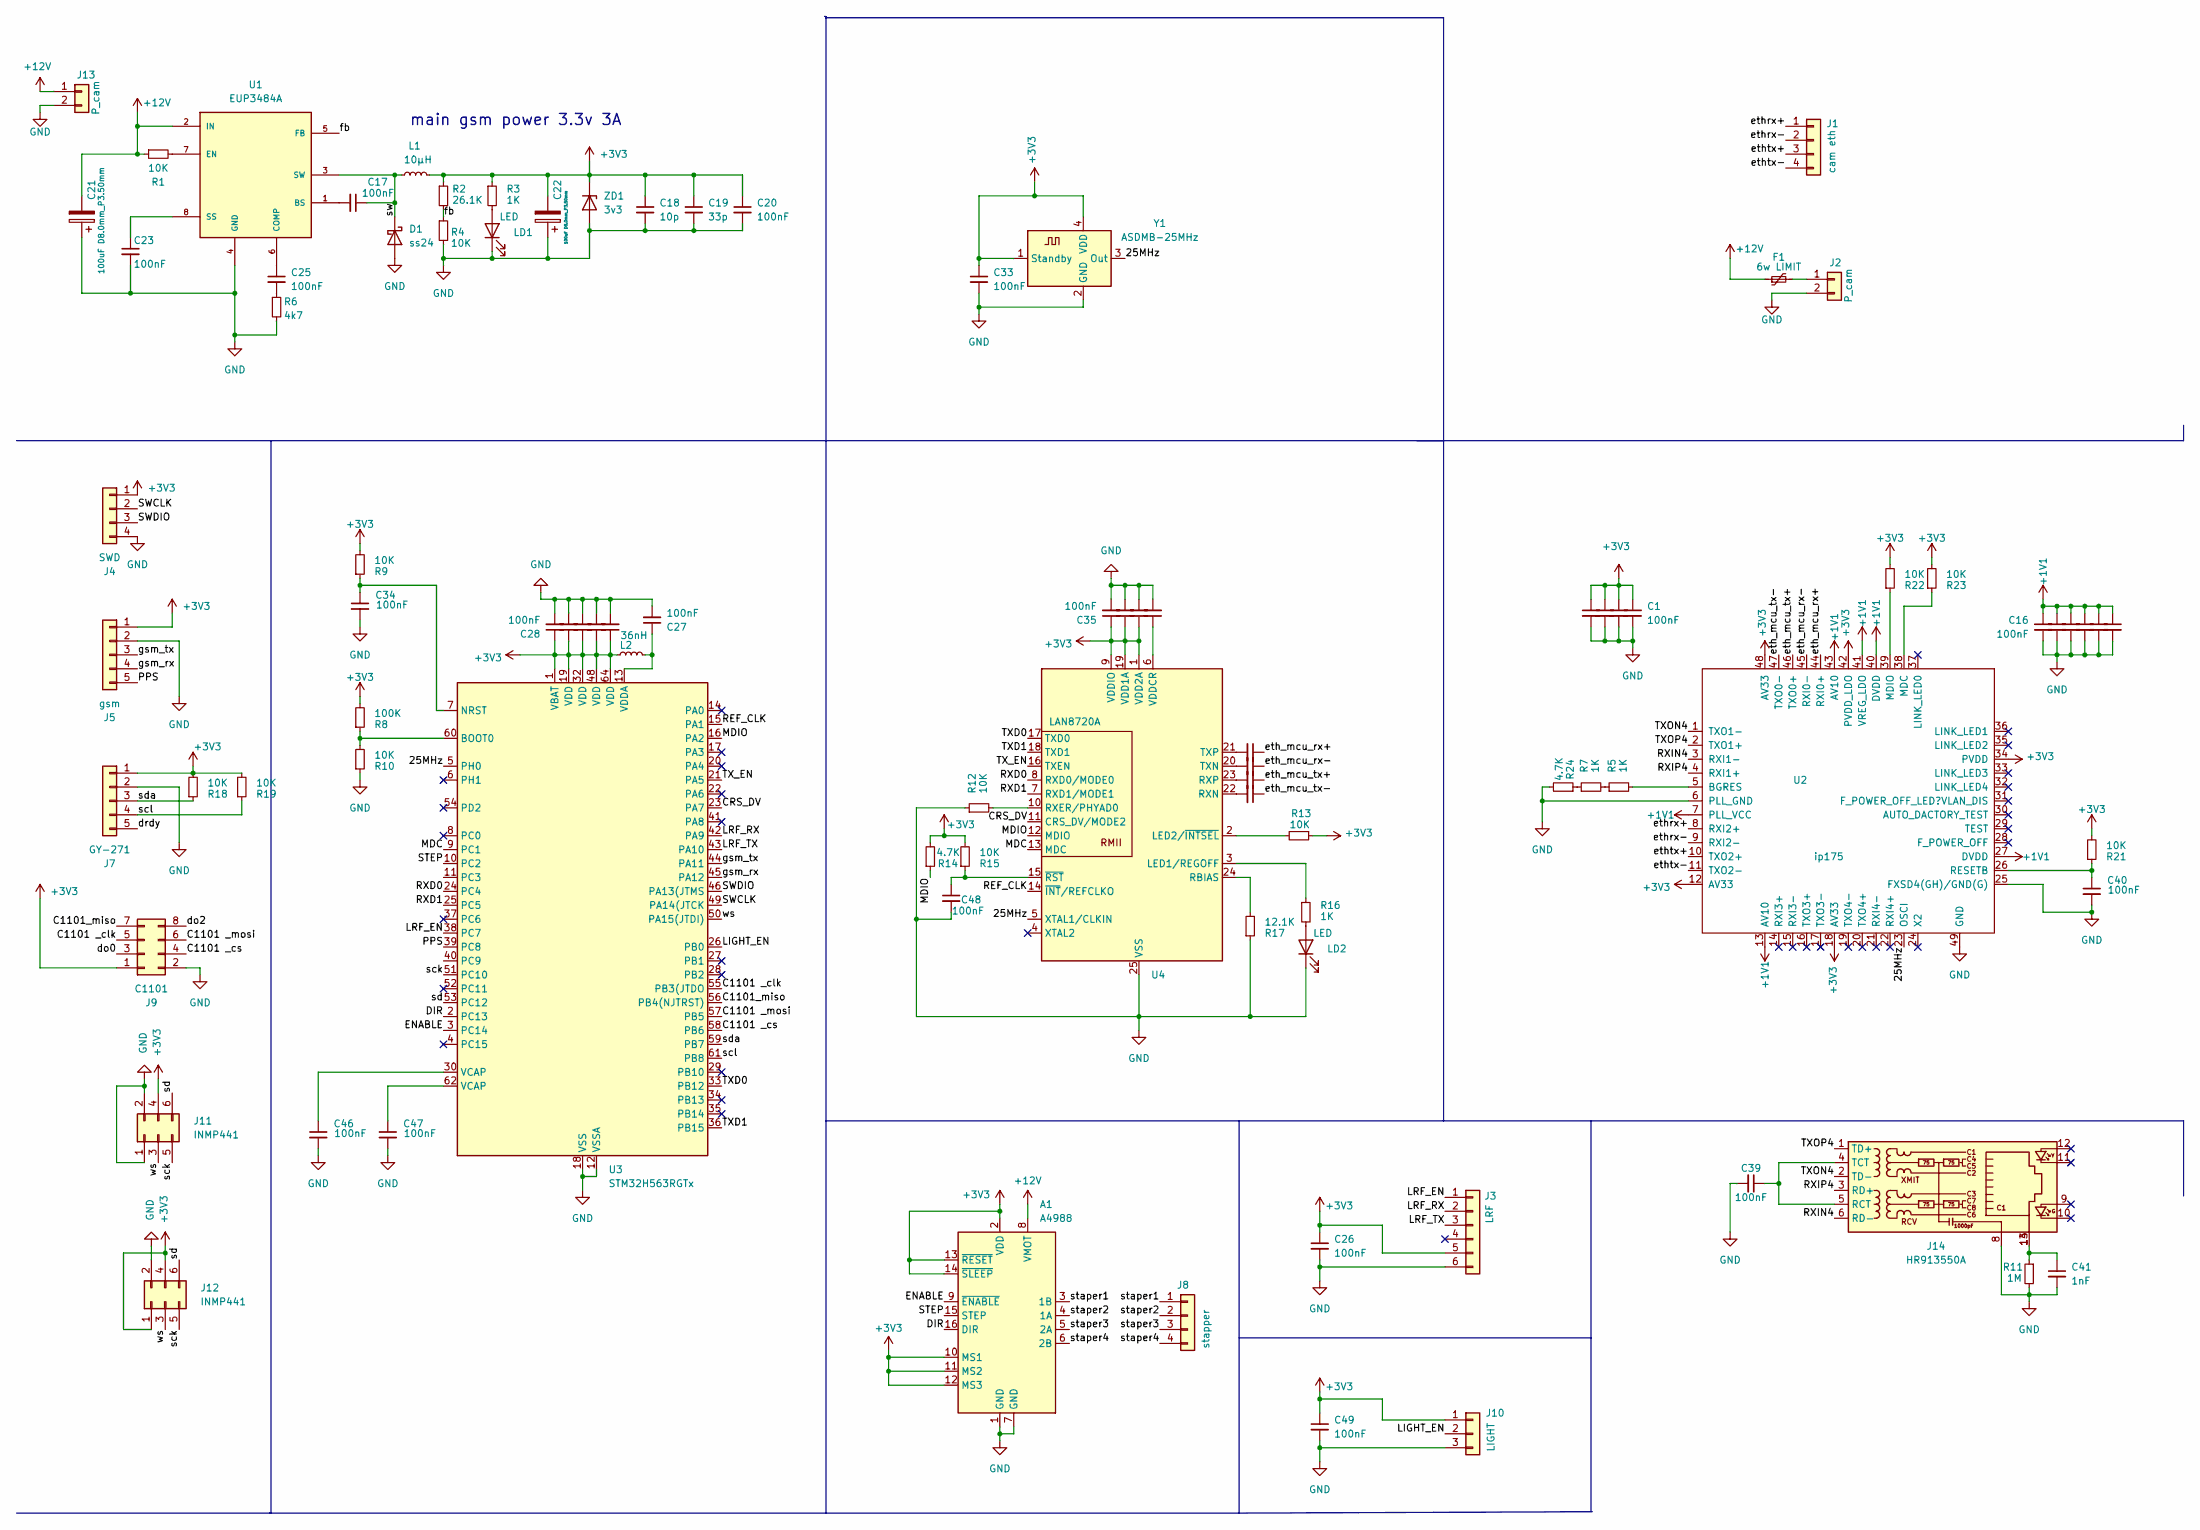
[picture p41: schematic drone.kicad_sch]

Parts:
A1: A4988; Pololu_Breakout-16_15.2x20.3mm
C1, C2, C3, C4, C11, C12, C13, C14, C15, C16, C17, C20, C23, C25, C26, C27, C28, C29, C30, C31, C32, C33, C34, C35, C36, C37, C38, C39, C40, C42, C43, C44, C45, C46, C47, C48, C49: 100nF; C_0603_1608Metric; Manufacturer_Part_Number SMD1206B050TF
C18: 10p; C_0603_1608Metric
C19: 33p; C_0603_1608Metric
C21, C22: 100uF D8.0mm_P3.50mm; CP_Radial_D6.3mm_P2.50mm
C41: 1nF; C_0603_1608Metric
D1: ss24; D_SMB
F1: 6w LIMIT; Fuse_1206_3216Metric
J1: cam eth; PinHeader_1x04_P2.54mm_Vertical
J2, J13: P_cam; PinHeader_1x02_P2.54mm_Vertical
J3: LRF; JST_EH_B6B-EH-A_1x06_P2.50mm_Vertical
J4: SWD; PinHeader_1x04_P2.00mm_Vertical
J5: gsm; PinHeader_1x05_P2.54mm_Vertical
J7: GY-271; PinHeader_1x05_P2.54mm_Vertical
J8: stapper; PinHeader_1x04_P2.54mm_Vertical
J9: C1101; PinHeader_2x04_P2.54mm_Vertical
J10: LIGHT; PinHeader_1x03_P2.54mm_Vertical
J11, J12: INMP441; PinHeader_2x03_P2.54mm_Vertical
J14: HR913550A; HR913550A_HAN
L1: 10µH; CP_Radial_Tantal_D4.5mm_P2.50mm
L2: 36nH; L_0603_1608Metric
LD1, LD2: LED; LED_0603_1608Metric
R1, R4, R9, R10, R12, R13, R15, R18, R19, R21, R22, R23: 10K; R_0603_1608Metric
R2: 26.1K; R_0603_1608Metric
R3, R5, R7, R16: 1K; R_0603_1608Metric
R6: 4k7; R_0603_1608Metric
R8: 100K; R_0603_1608Metric
R11: 1M; R_0603_1608Metric
R14, R24: 4.7K; R_0603_1608Metric
R17: 12.1K; R_0603_1608Metric
U1: EUP3484A; SOIC-8_3.9x4.9mm_P1.27mm
U2: ip175; QFN40P600X600X90-49N-D
U3: STM32H563RGTx; LQFP-64_10x10mm_P0.5mm
U4: LAN8720A; VQFN-24-1EP_4x4mm_P0.5mm_EP2.5x2.5mm_ThermalVias
Y1: ASDMB-25MHz; Oscillator_SMD_Abracon_ASDMB-4Pin_2.5x2.0mm
ZD1: 3v3; D_SMB

Connections:
25MHz: U2.23 (OSCI), U3.5 (PH0), U4.5 (XTAL1/CLKIN), Y1.3 (Out)
+1V1: C11.1, C12.1, C13.1, C14.1, C15.1, C16.1, U2.7 (PLL_VCC), U2.13 (AV10), U2.27 (DVDD), U2.40 (DVDD), U2.41 (VREG_LDO), U2.43 (AV10)
+3V3: A1.2 (VDD), A1.10 (MS1), A1.11 (MS2), A1.12 (MS3), A1.13 (~RESET), A1.14 (~SLEEP), C1.1, C2.1, C3.1, C4.1, C18.1, C19.1, C20.1, C22.2, C26.1, C28.1, C29.1, C30.1, C31.1, C32.1, C33.1, C35.1, C36.1, C37.1, C49.1, J3.5, J4.1, J5.1, J7.1, J9.1, J10.1, J11.4, J12.1, J12.4, L1.2, L2.1, R2.1, R3.1, R8.2, R9.2, R13.1, R14.2, R15.2, R18.2, R19.2, R21.2, R22.2, R23.2, U2.12 (AV33), U2.18 (AV33), U2.34 (PVDD), U2.42 (PVDD_LDO), U2.48 (AV33), U3.1 (VBAT), U3.19 (VDD), U3.32 (VDD), U3.48 (VDD), U3.64 (VDD), U4.1 (VDD2A), U4.9 (VDDIO), U4.19 (VDD1A), Y1.1 (Standby), Y1.4 (VDD), ZD1.1 (K)
+12V: A1.8 (VMOT), C21.2, F1.1, J13.1, R1.1, U1.2 (IN)
C1101 _clk: J9.5, U3.55 (PB3(JTDO)
C1101 _cs: J9.4, U3.58 (PB6)
C1101 _mosi: J9.6, U3.57 (PB5)
C1101_miso: J9.7, U3.56 (PB4(NJTRST))
CRS_DV: U3.23 (PA7), U4.11 (CRS_DV/MODE2)
DIR: A1.16 (DIR), U3.2 (PC13)
ENABLE: A1.9 (~ENABLE), U3.3 (PC14)
GND: A1.1 (GND), A1.7 (GND), C1.2, C2.2, C3.2, C4.2, C11.2, C12.2, C13.2, C14.2, C15.2, C16.2, C18.2, C19.2, C20.2, C21.1, C22.1, C23.2, C26.2, C27.2, C28.2, C29.2, C30.2, C31.2, C32.2, C33.2, C34.2, C35.2, C36.2, C37.2, C38.2, C39.2, C40.2, C41.2, C46.2, C47.2, C48.2, C49.2, D1.2 (A), J2.2, J3.6, J4.4, J5.2, J7.2, J9.2, J10.3, J11.1, J11.2, J12.2, J13.2, J14.8, LD1.1 (K), LD2.1 (K), R4.2, R6.2, R10.1, R11.2, R12.1, R17.1, R24.2, U1.4 (GND), U2.6 (PLL_GND), U2.25 (FXSD4(GH)/GND(G)), U2.49 (GND), U3.12 (VSSA), U3.18 (VSS), U3.31 (VSS), U3.47 (VSS), U3.63 (VSS), U4.25 (VSS), Y1.2 (GND), ZD1.2 (A)
LIGHT_EN: J10.2, U3.26 (PB0)
LRF_EN: J3.1, U3.38 (PC7)
LRF_RX: J3.2, U3.42 (PA9)
LRF_TX: J3.3, U3.43 (PA10)
MDC: U3.9 (PC1), U4.13 (MDC)
MDIO: R14.1, U3.16 (PA2), U4.12 (MDIO)
unnamed: C17.2, U1.1 (BS)
unnamed: C23.1, U1.8 (SS)
unnamed: C25.1, U1.6 (COMP)
unnamed: C25.2, R6.1
unnamed: C27.1, L2.2, U3.13 (VDDA)
unnamed: C34.1, R9.1, U3.7 (NRST)
unnamed: C38.1, U4.6 (VDDCR)
unnamed: C39.1, J14.4 (TCT), J14.5 (RCT)
unnamed: C40.1, R21.1, U2.26 (RESETB)
unnamed: C41.1, J14.13, J14.14, R11.1
unnamed: C42.2, U4.21 (TXP)
unnamed: C43.2, U4.20 (TXN)
unnamed: C44.2, U4.23 (RXP)
unnamed: C45.2, U4.22 (RXN)
unnamed: C46.1, U3.30 (VCAP)
unnamed: C47.1, U3.62 (VCAP)
unnamed: C48.1, R15.1, U4.15 (~RST)
unnamed: F1.2, J2.1
unnamed: LD1.2 (A), R3.2
unnamed: LD2.2 (A), R16.2
unnamed: R1.2, U1.7 (EN)
unnamed: R5.1, R7.2
unnamed: R5.2, U2.5 (BGRES)
unnamed: R8.1, R10.2, U3.60 (BOOT0)
unnamed: R12.2, U4.10 (RXER/PHYAD0)
unnamed: R13.2, U4.2 (LED2/~INTSEL)
unnamed: R16.1, U4.3 (LED1/REGOFF)
unnamed: R17.2, U4.24 (RBIAS)
unnamed: R22.1, U2.39 (MDIO)
unnamed: R23.1, U2.38 (MDC)
unnamed: R7.1, R24.1
PPS: J5.5, U3.39 (PC8)
REF_CLK: U3.15 (PA1), U4.14 (~INT/REFCLKO)
RXD0: U3.24 (PC4), U4.8 (RXD0/MODE0)
RXD1: U3.25 (PC5), U4.7 (RXD1/MODE1)
RXIN4: J14.6 (RD-), U2.3 (RXI1-)
RXIP4: J14.3 (RD+), U2.4 (RXI1+)
STEP: A1.15 (STEP), U3.10 (PC2)
SWCLK: J4.2, U3.49 (PA14(JTCK)
SWDIO: J4.3, U3.46 (PA13(JTMS)
TXD0: U3.33 (PB12), U4.17 (TXD0)
TXD1: U3.36 (PB15), U4.18 (TXD1)
TXON4: J14.2 (TD-), U2.1 (TXO1-)
TXOP4: J14.1 (TD+), U2.2 (TXO1+)
TX_EN: U3.21 (PA5), U4.16 (TXEN)
do0: J9.3
do2: J9.8
drdy: J7.5
eth_mcu_rx+: C42.1, U2.44 (RXI0+)
eth_mcu_rx-: C43.1, U2.45 (RXI0-)
eth_mcu_tx+: C44.1, U2.46 (TXO0+)
eth_mcu_tx-: C45.1, U2.47 (TXO0-)
ethrx+: J1.1, U2.8 (RXI2+)
ethrx-: J1.2, U2.9 (RXI2-)
ethtx+: J1.3, U2.10 (TXO2+)
ethtx-: J1.4, U2.11 (TXO2-)
fb: R2.2, R4.1, U1.5 (FB)
gsm_rx: J5.4, U3.45 (PA12)
gsm_tx: J5.3, U3.44 (PA11)
sck: J11.5, J12.5, U3.51 (PC10)
scl: J7.4, R19.1, U3.61 (PB8)
sd: J11.6, J12.6, U3.53 (PC12)
sda: J7.3, R18.1, U3.59 (PB7)
staper1: A1.3 (1B), J8.1
staper2: A1.4 (1A), J8.2
staper3: A1.5 (2A), J8.3
staper4: A1.6 (2B), J8.4
sw: C17.1, D1.1 (K), L1.1, U1.3 (SW)
ws: J11.3, J12.3, U3.50 (PA15(JTDI))

Notes on the sheet:
main gsm power 3.3v 3A
