Shuvadeep2407/cir/(notices)

Notices in the files:
rxtr/rader 1/Core/Src/main.c:
Copyright (c) 2026 STMicroelectronics.
All rights reserved.
This software is licensed under terms that can be found in the LICENSE file
